Coral-coder/OpenRook/3d-prints/stl/capture_strip.stl

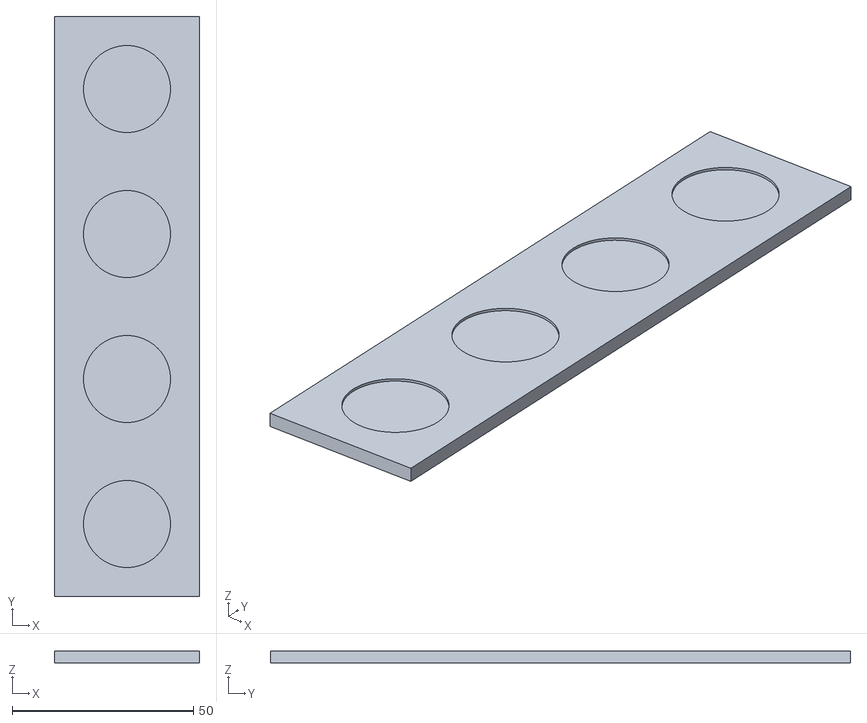
[picture p1: CAD file, 2026-11-02]
3d-prints/stl/capture_strip.stl
40.0 x 160.0 x 3.40
