Coral-coder/OpenRook/3d-prints/stl/idler_mount_left.stl

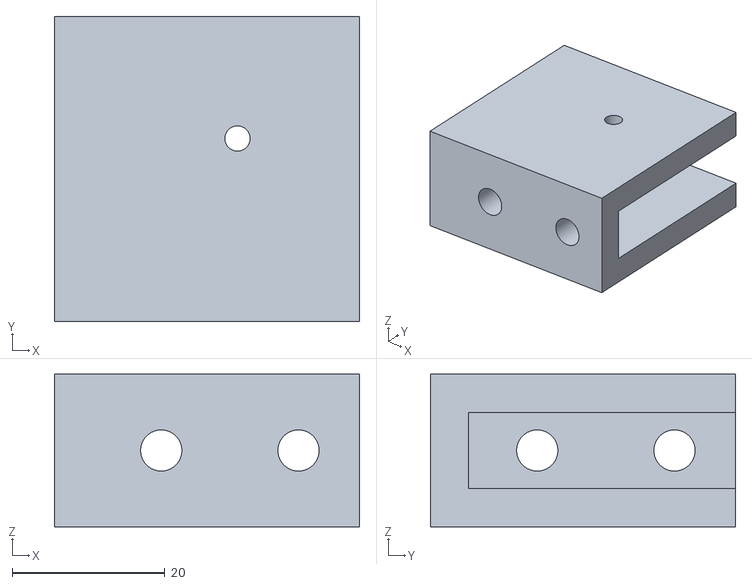
[picture p2: CAD file, 2026-11-02]
3d-prints/stl/idler_mount_left.stl
40.0 x 40.0 x 20.0
