Coral-coder/OpenRook/3d-prints/stl/xy_carriage.stl

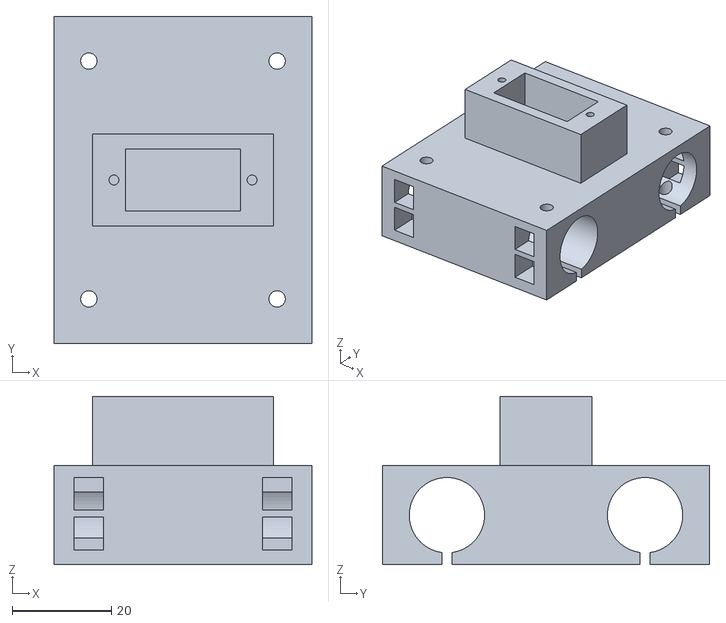
[picture p3: CAD file, 2026-11-02]
3d-prints/stl/xy_carriage.stl
52.0 x 66.0 x 34.0
