Coral-coder/OpenRook/3d-prints/stl/piece_queen.stl

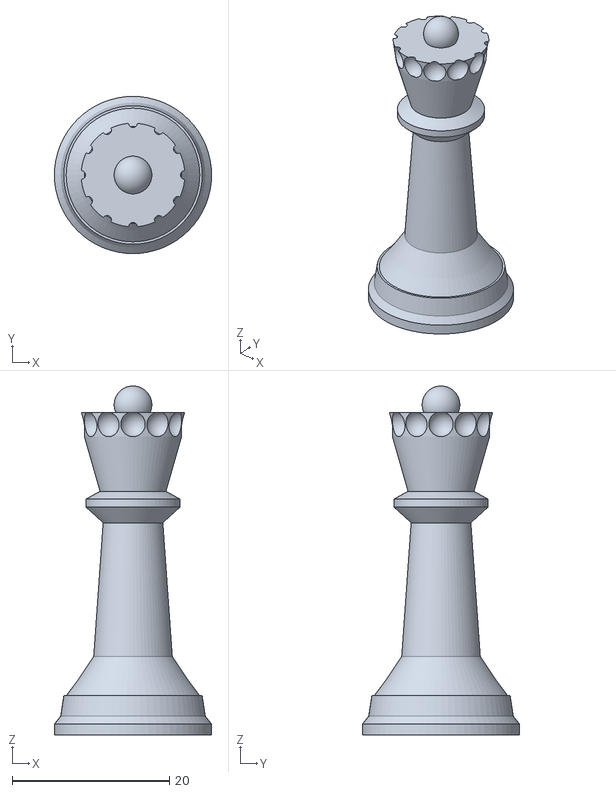
[picture p4: CAD file, 2026-11-02]
3d-prints/stl/piece_queen.stl
20.0 x 20.0 x 44.4
