Coral-coder/OpenRook/3d-prints/stl/rod_holder.stl

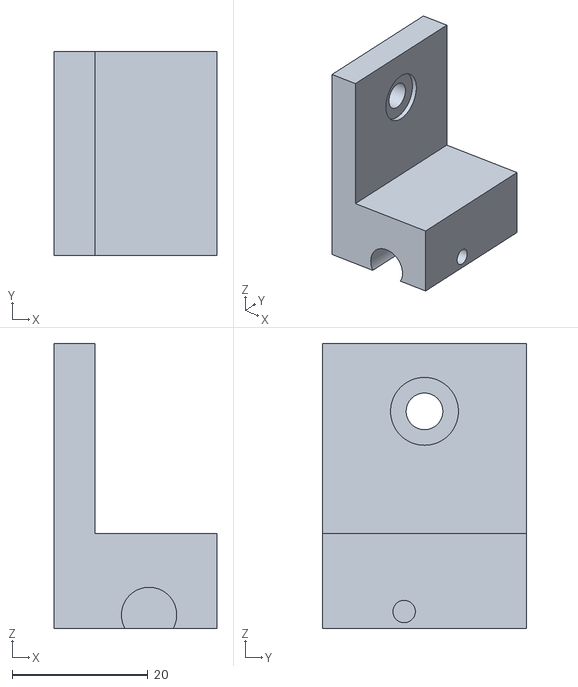
[picture p5: CAD file, 2026-11-02]
3d-prints/stl/rod_holder.stl
24.0 x 30.0 x 42.0
