Coral-coder/OpenRook/3d-prints/stl/electronics_case_lid.stl

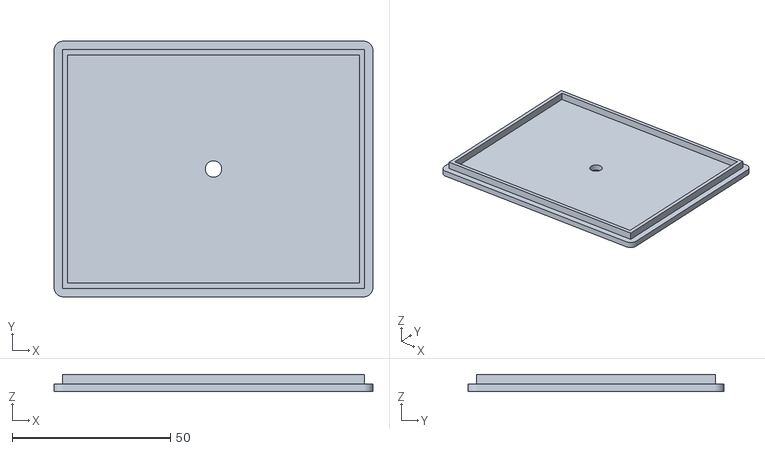
[picture p6: CAD file, 2026-11-02]
3d-prints/stl/electronics_case_lid.stl
100.8 x 80.8 x 5.40
