Coral-coder/OpenRook/3d-prints/stl/pieces_preview_set.stl

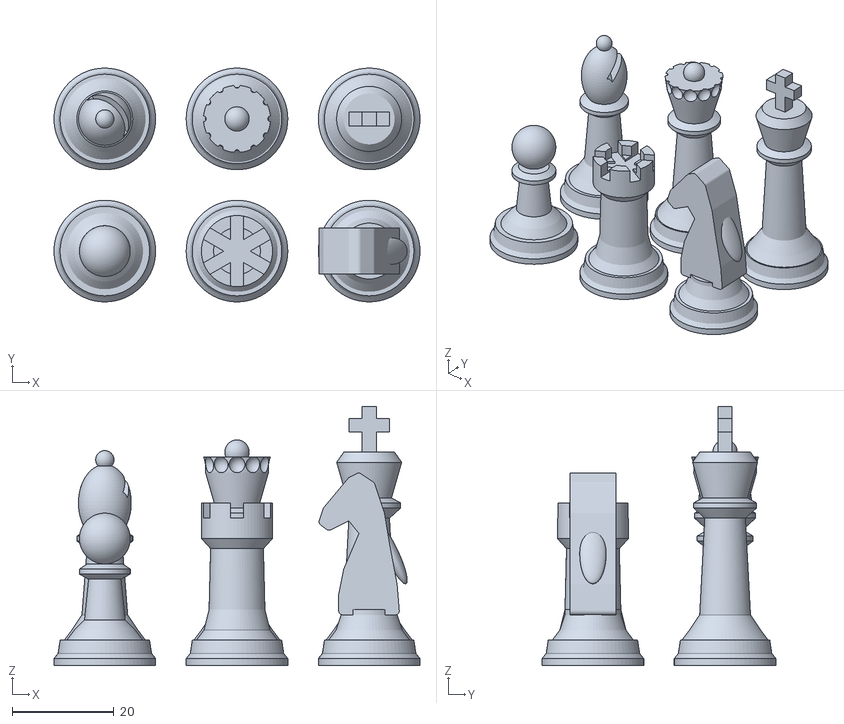
[picture p7: CAD file, 2026-11-02]
3d-prints/stl/pieces_preview_set.stl
72.0 x 46.0 x 51.0
