Coral-coder/OpenRook/3d-prints/stl/electronics_case.stl

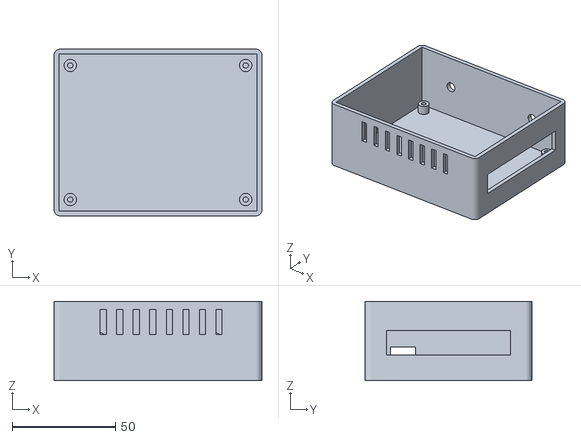
[picture p8: CAD file, 2026-11-02]
3d-prints/stl/electronics_case.stl
100.8 x 80.8 x 38.4
