Coral-coder/OpenRook/3d-prints/stl/piece_knight.stl

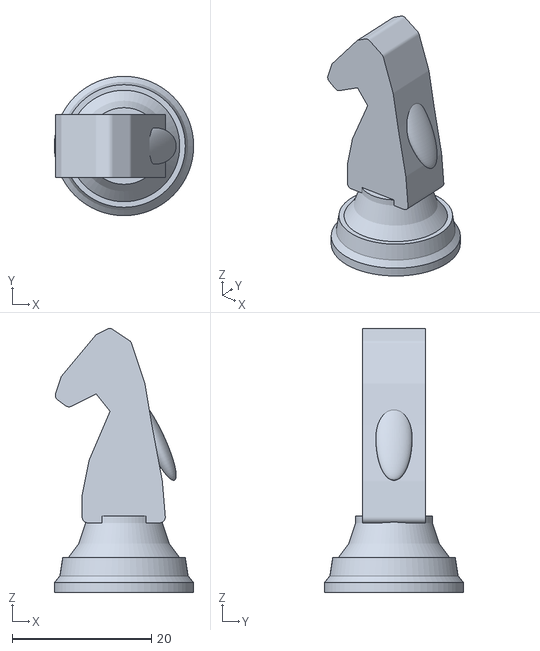
[picture p9: CAD file, 2026-11-02]
3d-prints/stl/piece_knight.stl
20.0 x 20.0 x 37.9
