Coral-coder/OpenRook/3d-prints/stl/motor_mount_right.stl

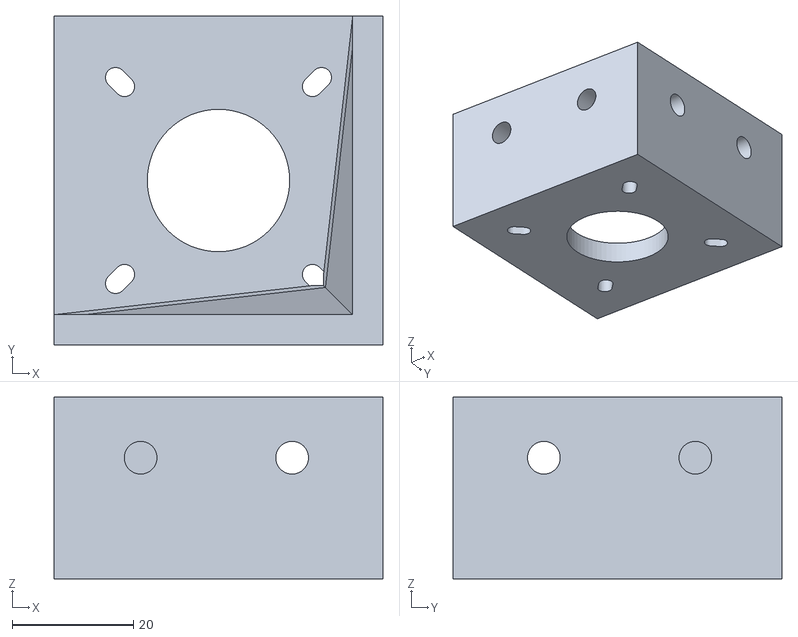
[picture p10: CAD file, 2026-11-02]
3d-prints/stl/motor_mount_right.stl
54.3 x 54.3 x 30.0
