Coral-coder/OpenRook/3d-prints/stl/piece_rook.stl

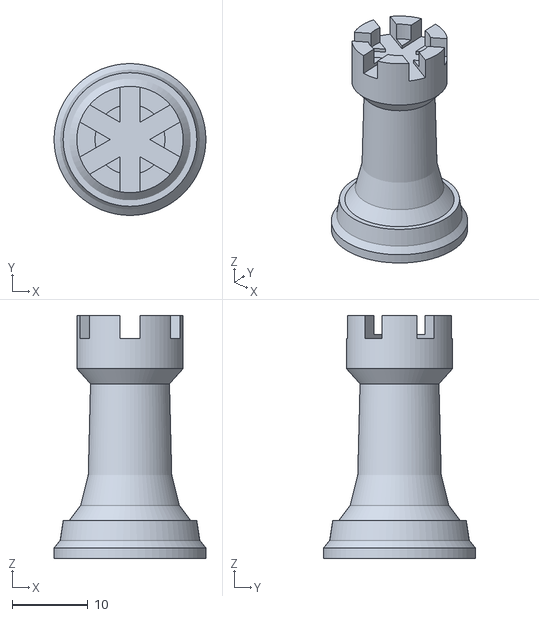
[picture p11: CAD file, 2026-11-02]
3d-prints/stl/piece_rook.stl
20.0 x 20.0 x 32.0
