Coral-coder/OpenRook/3d-prints/stl/piece_bishop.stl

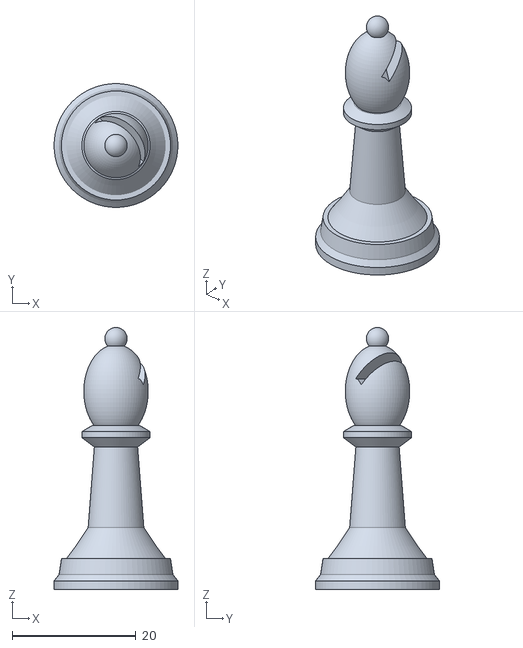
[picture p12: CAD file, 2026-11-02]
3d-prints/stl/piece_bishop.stl
20.0 x 20.0 x 42.3
