Coral-coder/OpenRook/3d-prints/stl/piece_pawn.stl

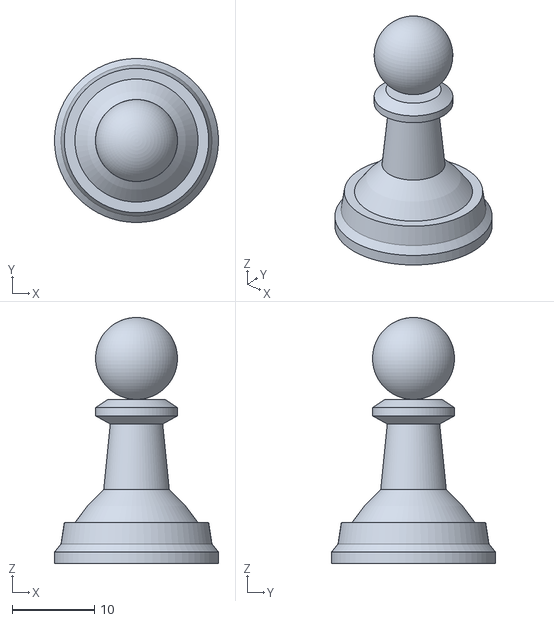
[picture p13: CAD file, 2026-11-02]
3d-prints/stl/piece_pawn.stl
20.0 x 20.0 x 30.0
