Coral-coder/OpenRook/3d-prints/stl/magnet_arm.stl

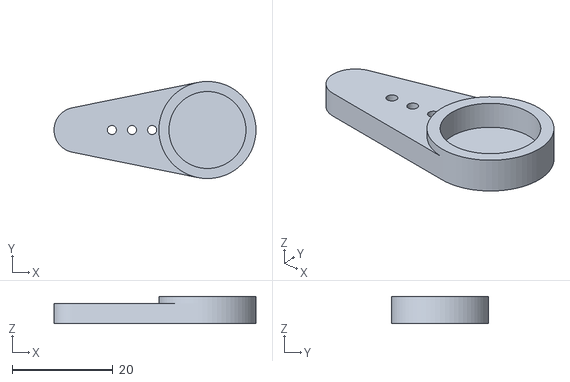
[picture p14: CAD file, 2026-11-02]
3d-prints/stl/magnet_arm.stl
40.2 x 19.3 x 5.40
