Coral-coder/OpenRook/3d-prints/stl/foot.stl

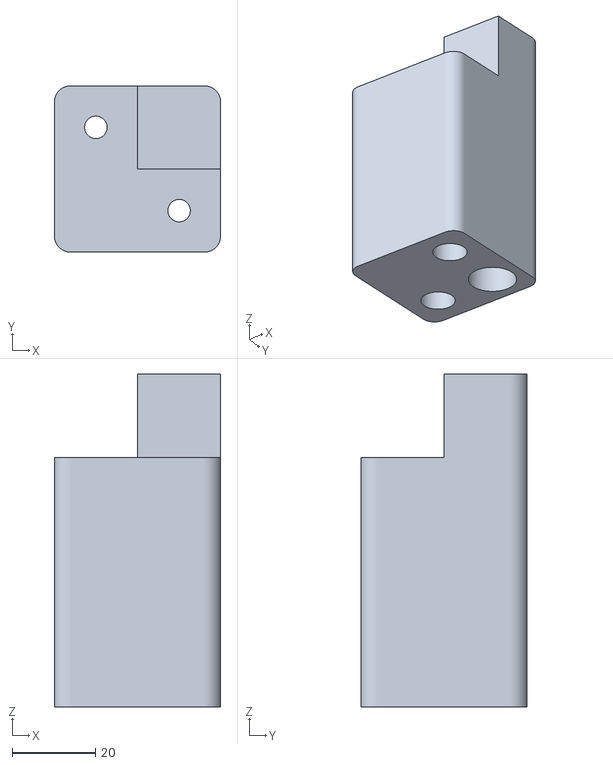
[picture p15: CAD file, 2026-11-02]
3d-prints/stl/foot.stl
40.0 x 40.0 x 80.0
