Coral-coder/OpenRook/3d-prints/stl/dark_square_inlay.stl

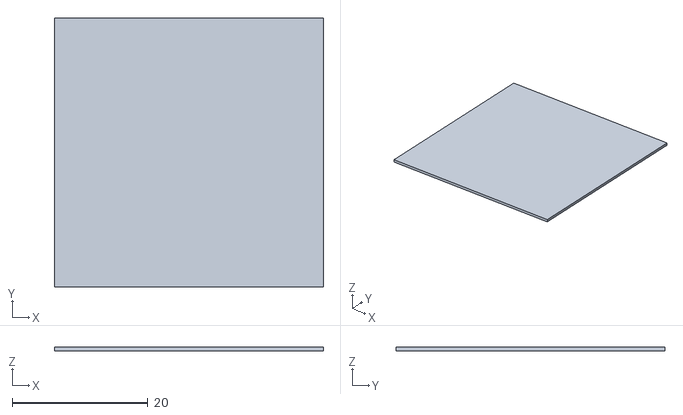
[picture p16: CAD file, 2026-11-02]
3d-prints/stl/dark_square_inlay.stl
39.7 x 39.7 x 0.55
