Coral-coder/OpenRook/3d-prints/stl/y_carriage_left.stl

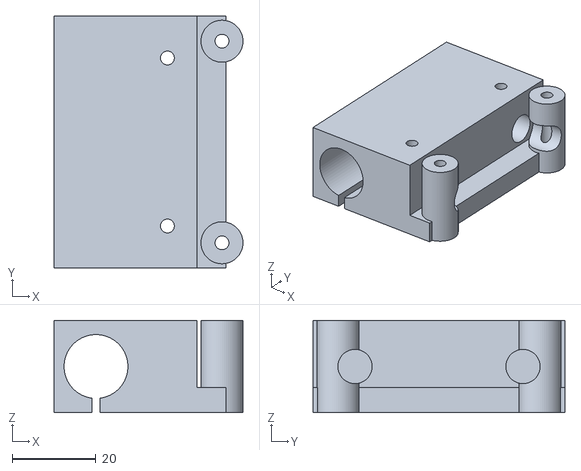
[picture p17: CAD file, 2026-11-02]
3d-prints/stl/y_carriage_left.stl
45.0 x 60.0 x 22.0
