Coral-coder/OpenRook/3d-prints/stl/piece_king.stl

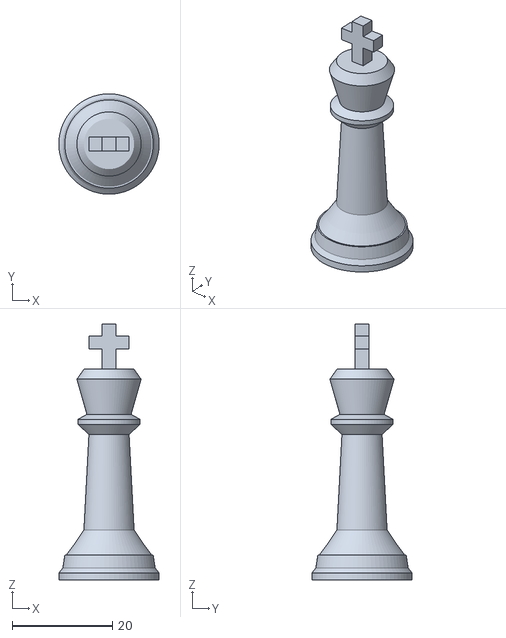
[picture p18: CAD file, 2026-11-02]
3d-prints/stl/piece_king.stl
20.0 x 20.0 x 51.0
