Coral-coder/OpenRook/3d-prints/stl/board_tile.stl

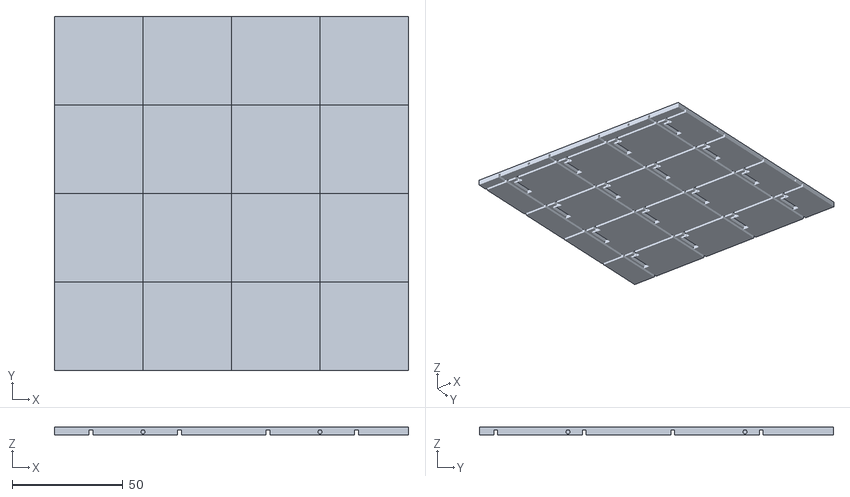
[picture p19: CAD file, 2026-11-02]
3d-prints/stl/board_tile.stl
160.0 x 160.0 x 3.40
