Coral-coder/OpenRook/(list of files, cad)

Other CAD files:
3d-prints/stl/idler_mount_right.stl
3d-prints/stl/motor_mount_left.stl
3d-prints/stl/y_carriage_right.stl
