Coral-coder/OpenRook/(commit log)

2026-11-02 OpenRook: ESP32 robotic chess board with a serverless online app
    - 3d-prints/: OpenSCAD sources and ready-to-slice STLs for the board tiles
    (reed-switch grooves), capture strips, magnet-base pieces and the CoreXY
    gantry parts.
    - hardware/: parts list, wiring/schematic (8x8 reed matrix via MCP23017,
    TMC2209 CoreXY, servo-lifted magnet) and a build guide.
    - firmware/: ESP32 Arduino sketch: debounced occupancy sensing, CoreXY
    motion with trapezoidal profiles, path planning along the lines between
    squares, BLE (Nordic UART) + serial line protocol, calibration in flash.
    - app/: Flutter app (Android, iOS, desktop, web) with its own rules engine
    (perft-verified) and computer player, mov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
    [board_tile.scad, board_tile.stl, capture_strip.scad, capture_strip.stl, common.scad, dark_square_inlay.scad, dark_square_inlay.stl, electronics_case.scad]
2026-11-02 3D battle board with animated armies, replays, voice moves; circuit schematics and a Mouser cart (#1)
    * Battle view, spoken moves and a move announcer; phone-first
    - Battle view: a tilted 3D stone board with carved vector pieces. Pieces
    march, knights leap, castling rooks vault the king; a capture is a fight
    (advance, rear back, strike) and the victim bursts into shards and dust
    with a flash, board shake and haptics. Promotions burst into light and a
    checkmated king crumbles. Moves queue so replies wait for the fight.
    - Say a move: speech_to_text plus a parser for spoken chess ("knight to f3",
    "e4", "bishop takes c6", "castle kingside", "a8 queen") that tolerates
    common misheari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
    [mouser-bom.csv]
2026-11-02 Wizard armies: stone statues, rot and ruin, clear-sight camera, open mic (#2)
    * Wizard armies: stone statues, rot and ruin, clear-sight camera, open mic
    - Default "Wizard" style: the characters become living chess statues with
    heroic proportions; white marble veined with glowing gold, black obsidian
    with pulsing green cracks. No on-screen bases. The KayKit look stays as the
    "Toon" option for kids.
    - A moonlit hall around the board: sky dome, gold and green magic light,
    braziers, rising motes and embers, drifting fog.
    - Deaths: blood or ichor sprays and stains the squares; a fallen body rots,
    its marble flesh bursts off to a bare skeleton, and the bones crumble to
    dust. Shattered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
2026-11-02 Make the battle readable on a phone: brighter light, thinner fog, portrait framing (#4)
    On a real iPhone the board was nearly black: the fog density was fixed, so
    the far-away portrait camera sank the whole board into it. The fog now
    scales with the camera's distance (it stays at the hall's edges), the
    moonlight, sky light and exposure are brighter, and tall screens look down
    more steeply so the board fills them.
    Claude-Session: https://claude.ai/code/session_01CiKekUhBL5YDNywDGk1EeU
